art-in/meteos/README.md

Home weather station on [ESP32](https://en.wikipedia.org/wiki/ESP32) with database and web app.

---

- environment readings:
  - temperature
  - humidity
  - pressure
  - co2
 - sending readings to database over wifi
 - configuring sensor over bluetooth
 - on-board display to show current readings
 - browser web app to show history charts
 - notifications through Telegram bot

---

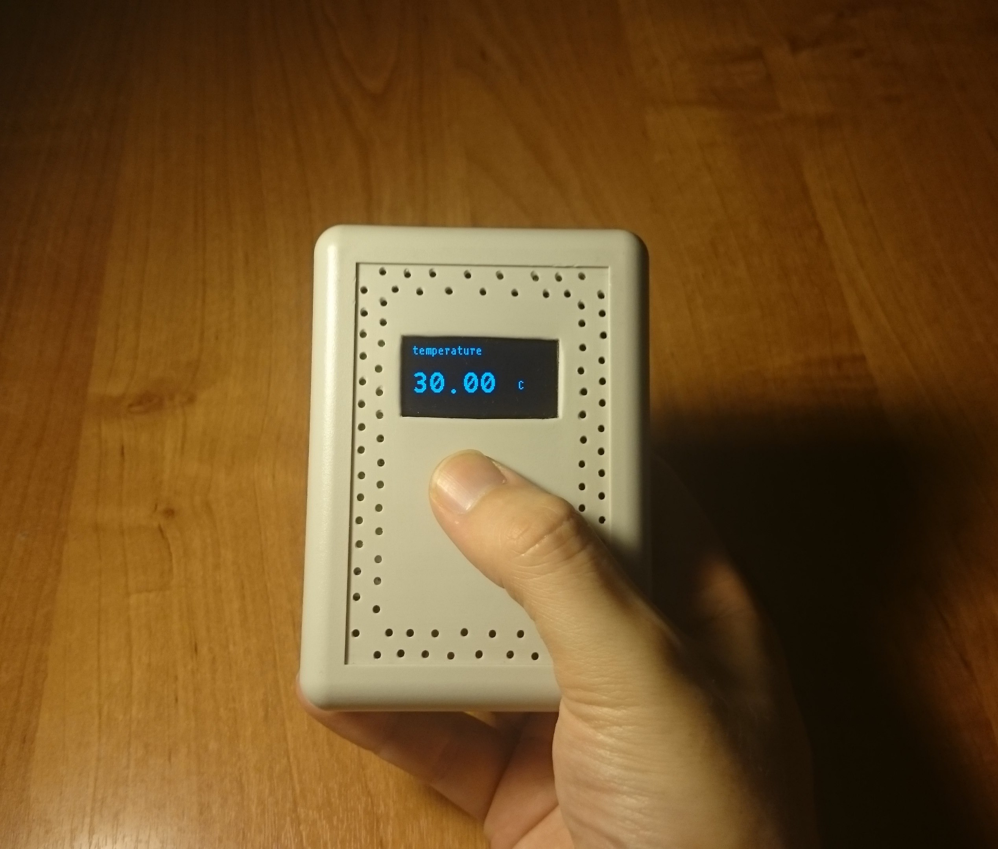
[picture p1: docs/sensor/photos/in-hand.jpg]
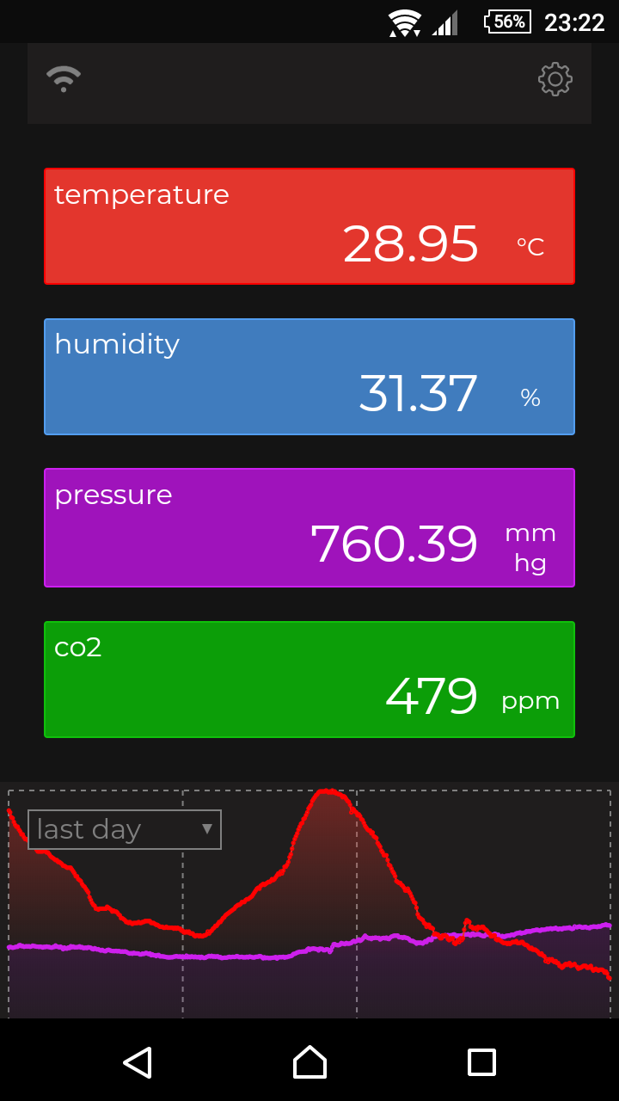
[picture p2: docs/web-app/phone.png]
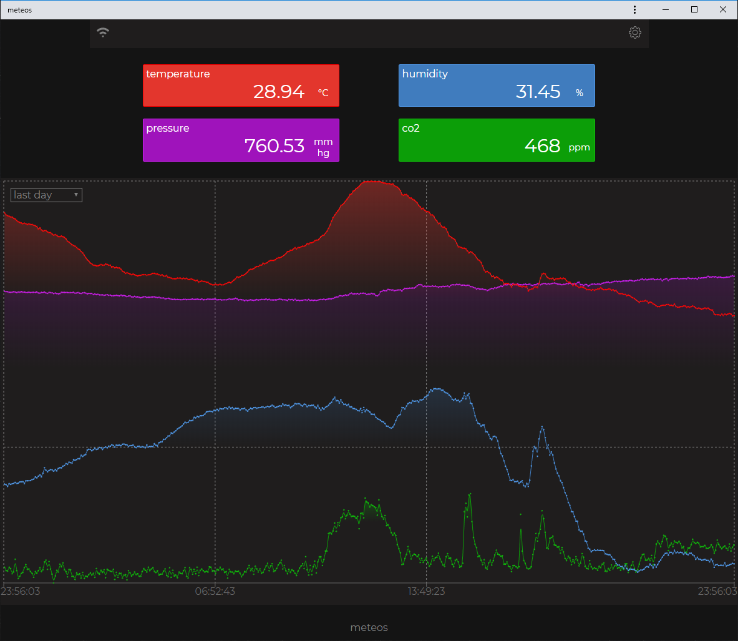
[picture p3: docs/web-app/desktop.png]
 |  | 
:---: | :---: | :---:

---

<a href="docs/architecture/meteos-architecture.pdf">
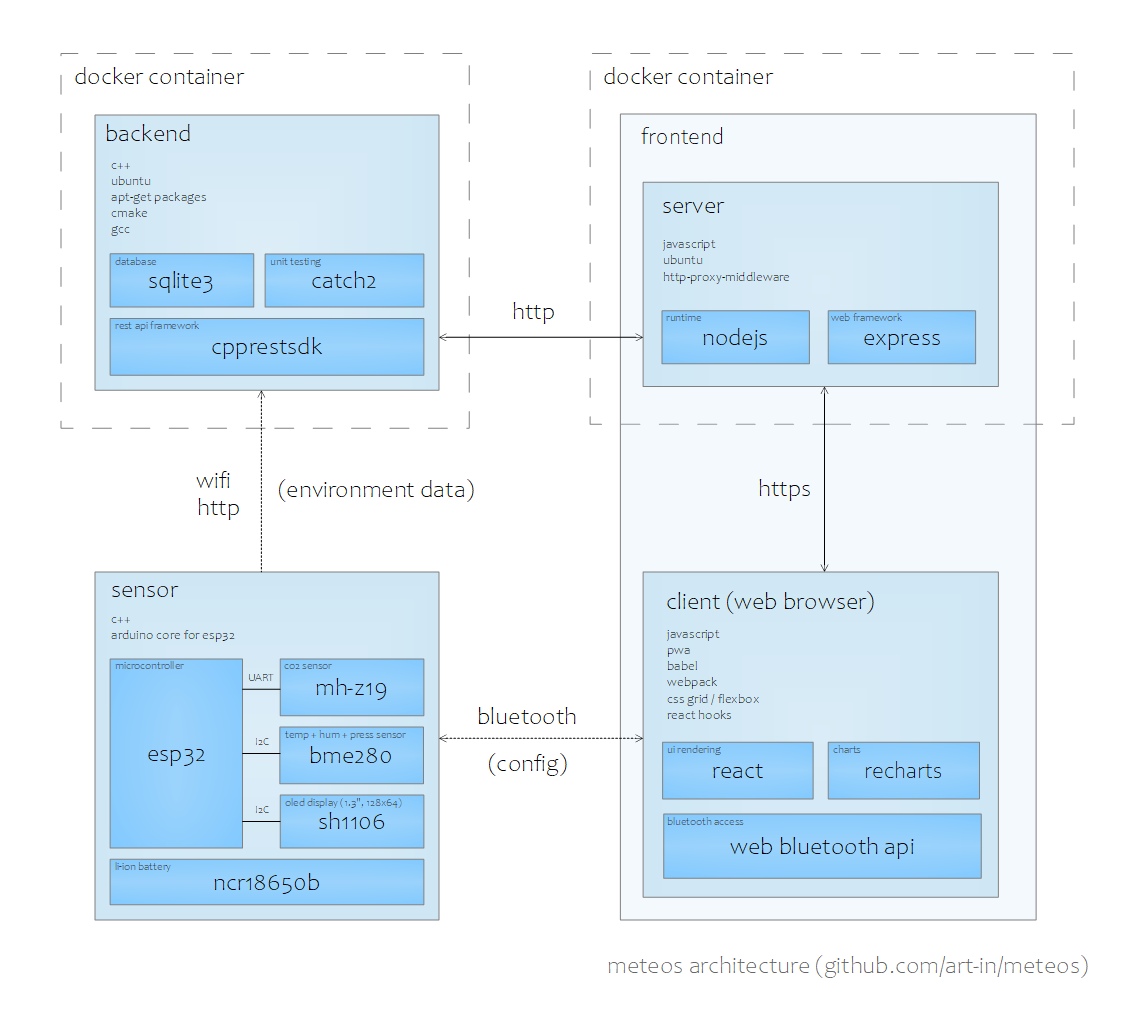
[picture p4: docs/architecture/meteos-architecture.png]

</a>

---

[Sensor device (components, circuit diagram, etc.)](docs/sensor/readme.md)

[Standards for indoor environmental quality](docs/environment-standards.md)
