art-in/meteos/docs/sensor/readme.md

### Components

component | model | link | photo 
--- | --- | --- | ---
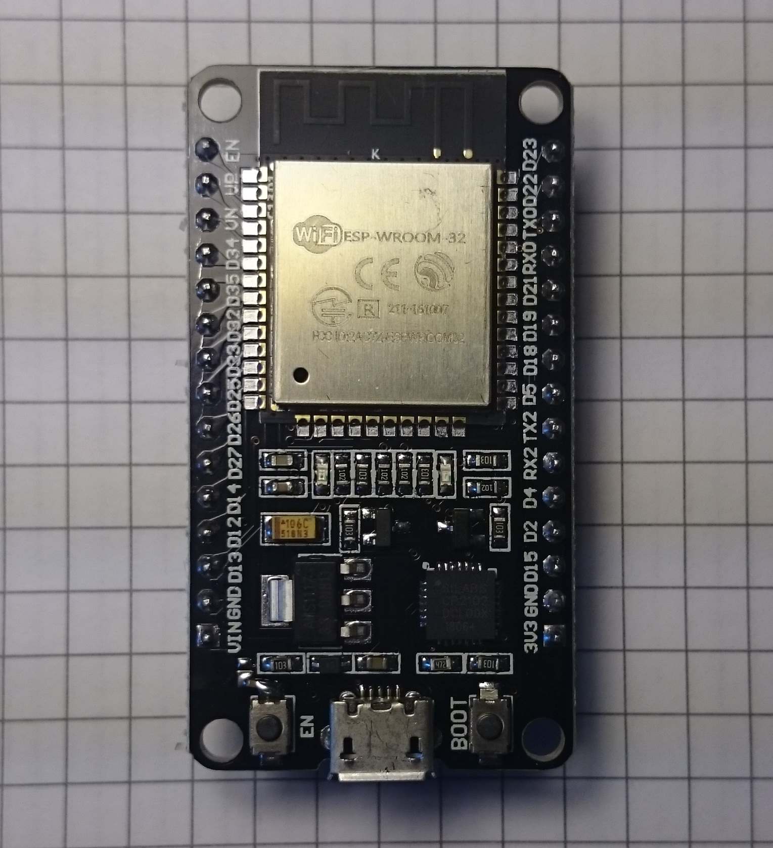
[picture p5: docs/sensor/photos/parts/esp32-dev-board.jpg]
microcontroller | esp32 doit devkit v1 | [aliexpress](http://aliexpress.com/item/ESP32-ESP-32-ESP32S-ESP-32S-CP2102-Wireless-WiFi-Bluetooth-Development-Board-Micro-USB-Dual-Core/32867696371.html) | 
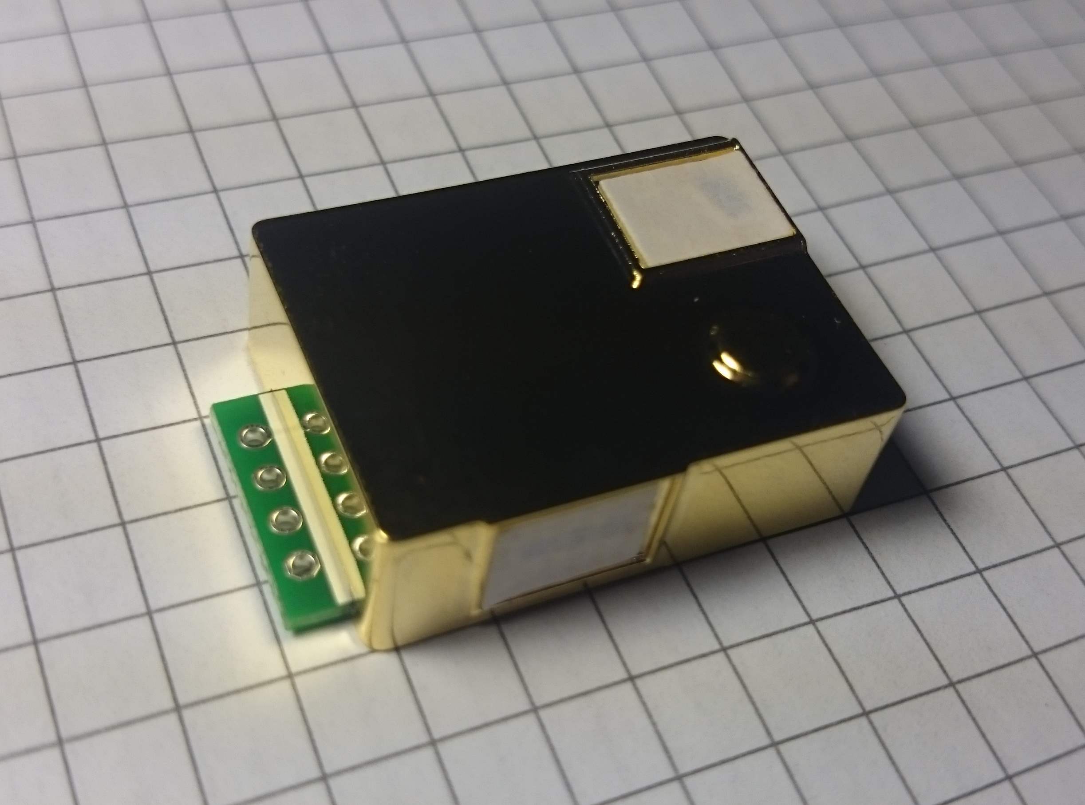
[picture p6: docs/sensor/photos/parts/mh-z19.jpg]
co2 sensor | mh-z19b | [aliexpress](http://aliexpress.com/item/1PCS-module-MH-Z19-infrared-co2-sensor-for-co2-monitor-Free-shipping/32371956420.html) | 
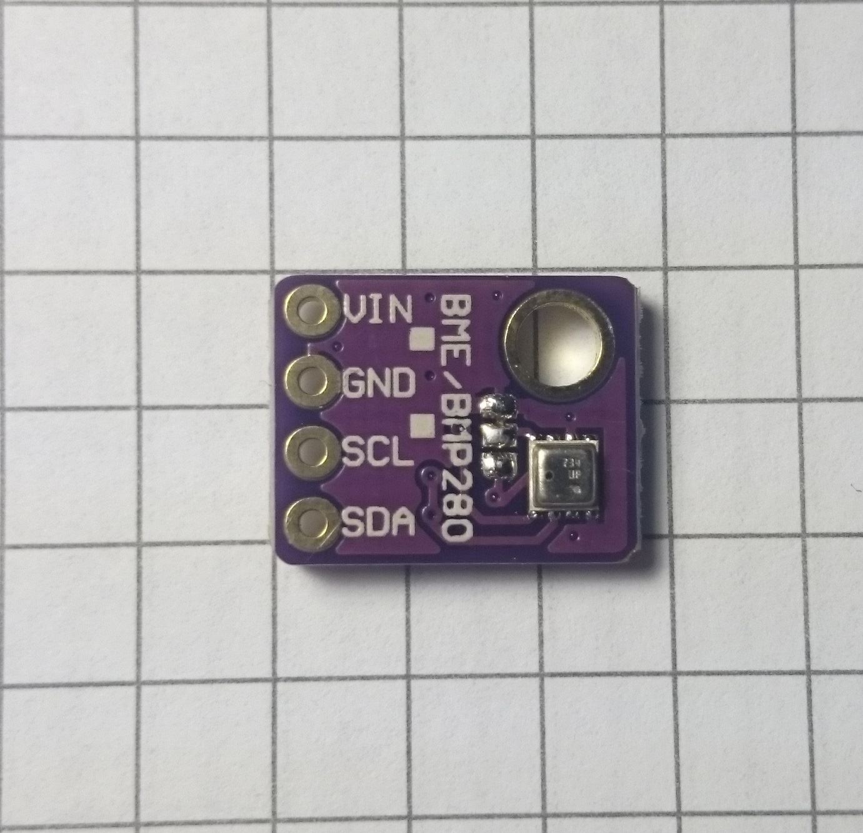
[picture p7: docs/sensor/photos/parts/bme280.jpg]
temperature, humidity, pressure sensor | bme280 | [aliexpress](http://aliexpress.com/store/product/BME280/731260_32849462236.html) | 
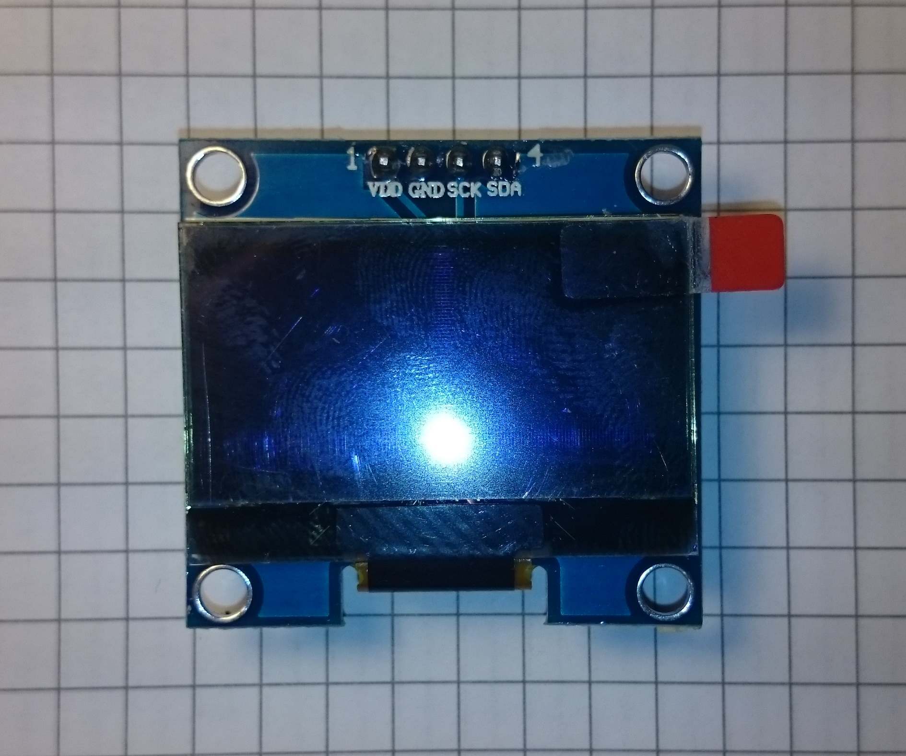
[picture p8: docs/sensor/photos/parts/sh1106.jpg]
OLED display (1.3", 128 x 64) | sh1106 | [aliexpress](http://aliexpress.com/item/1PCS-1-3-OLED-module-white-color-128X64-1-3-inch-OLED-LCD-LED-Display-Module/32796086867.html) | 
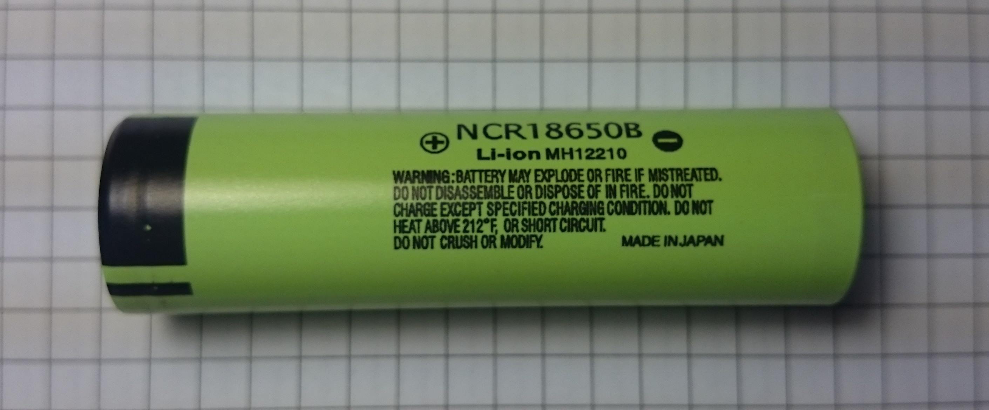
[picture p9: docs/sensor/photos/parts/ncr18650b.jpg]
li-ion battery (18650) | ncr18650b | [aliexpress](http://aliexpress.com/item/2PCS-100-New-Original-NCR18650B-3-7-v-3400-mah-18650-Lithium-Rechargeable-Battery-Flashlight-Digital/32324914059.html) | 
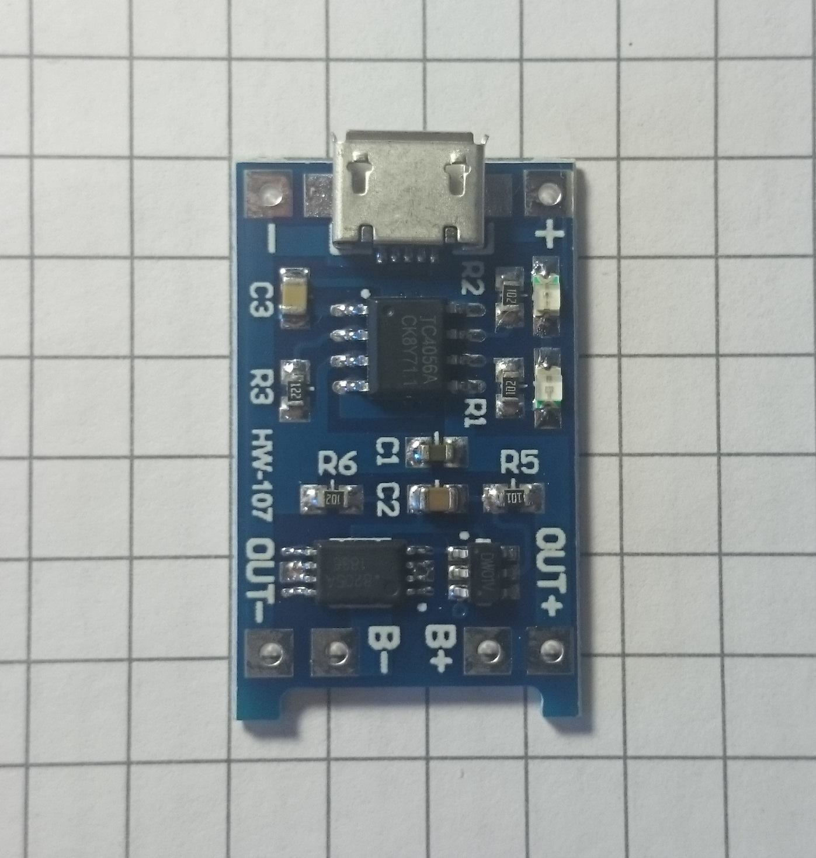
[picture p10: docs/sensor/photos/parts/tp4056.jpg]
li-ion battery charging board with protection | tp4056 | [aliexpress](http://aliexpress.com/item/1PCS-5V-1A-Micro-USB-18650-Lithium-Battery-Charging-Board-Charger-Module-Protection-Dual-Functions/32467578996.html) | 
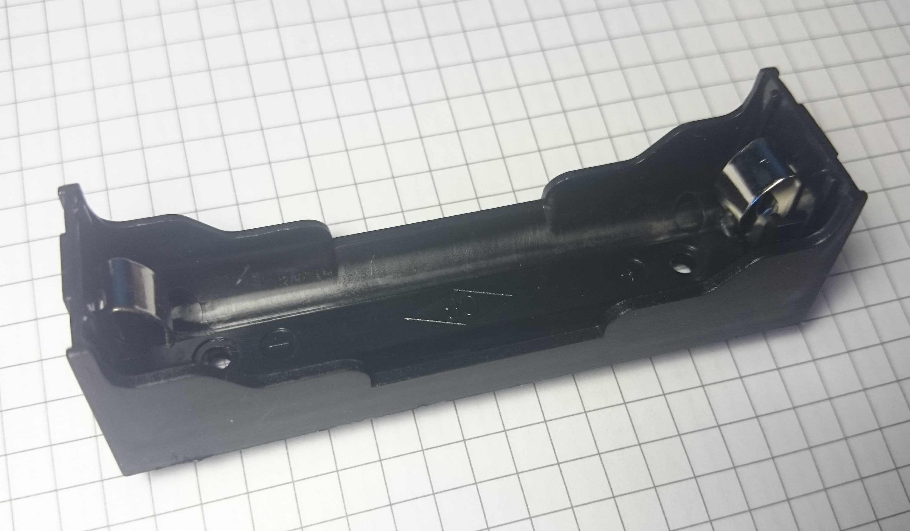
[picture p11: docs/sensor/photos/parts/battery-case.jpg]
battery case (18650) | - | [aliexpress](http://aliexpress.com/item/High-Quality-18650-Battery-Box-Holder-Batteries-Case-for-4pcs-18650-in-Parallel-3-7V-Pole/32814062027.html) | 
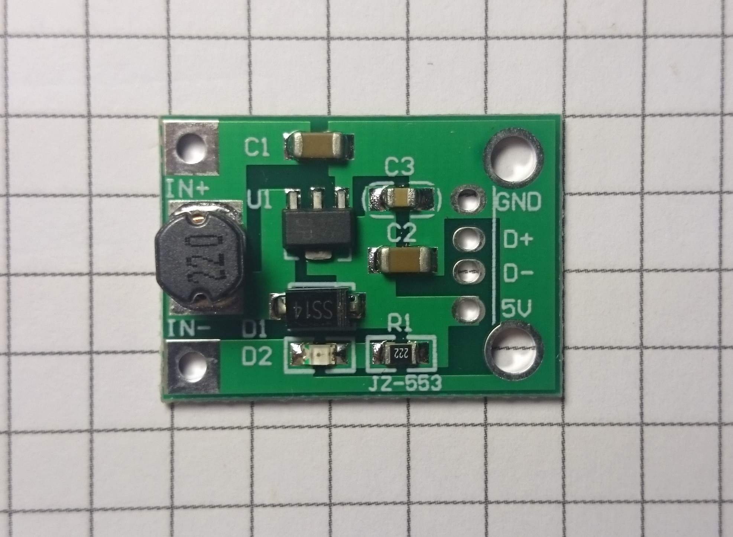
[picture p12: docs/sensor/photos/parts/stepup-converter.jpg]
step-up voltage converter (1V-5V to 5V) | - | [aliexpress](http://aliexpress.com/item/5V-DC-DC-Converter-Step-Up-Power-Supply-DC-DC-Booster-Boost-Buck-Converter-Board-Step/32635991770.html) | 
capacitor (1K μF) | - | -
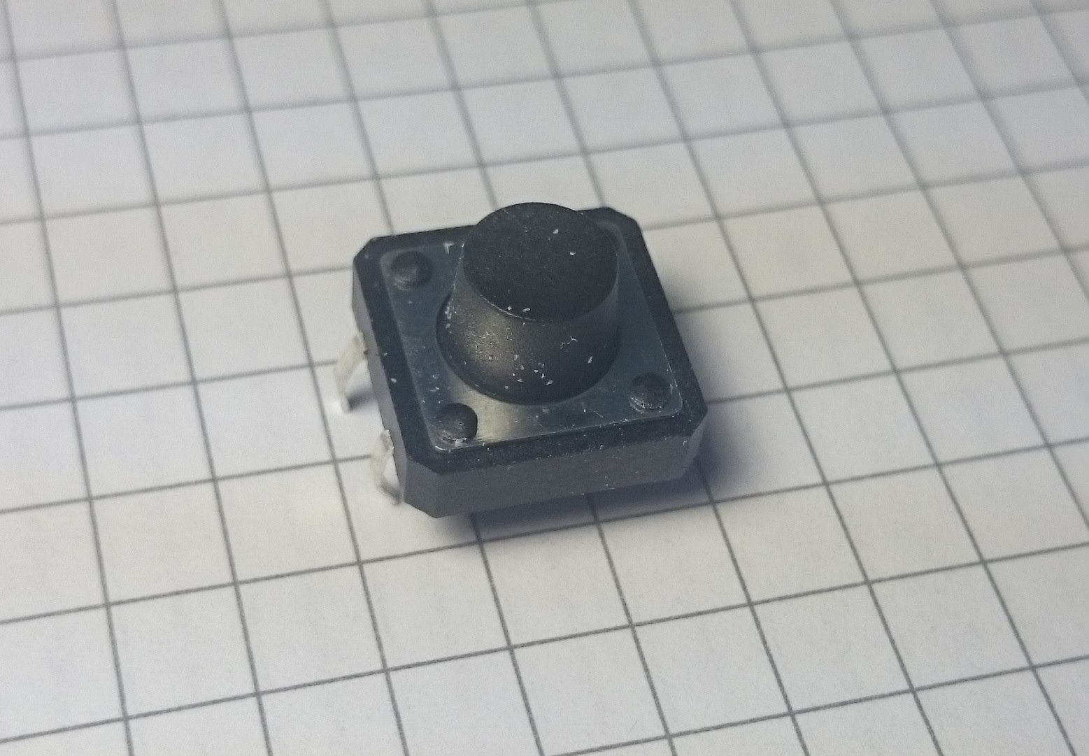
[picture p13: docs/sensor/photos/parts/button.jpg]
button | - | - | 
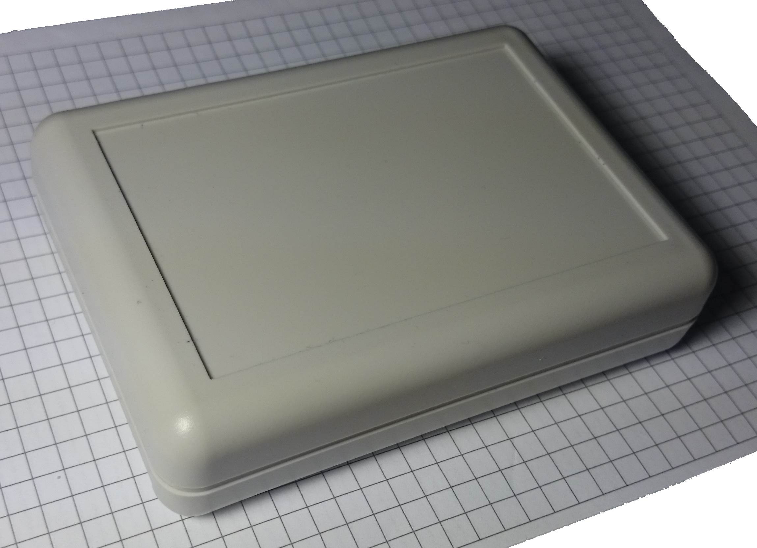
[picture p14: docs/sensor/photos/parts/case1.jpg]
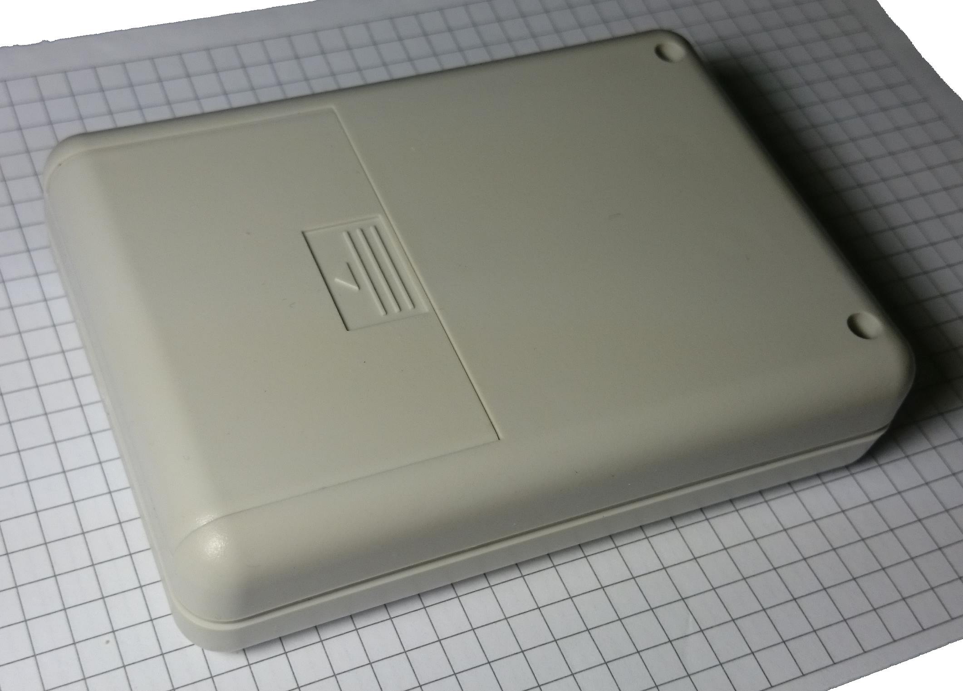
[picture p15: docs/sensor/photos/parts/case2.jpg]
plastic case (105 х 75 х 26.4 mm) | - | [chipdip (RU)](https://www.chipdip.ru/product/g909g) |  <br/> 

total cost (including shipment from China to Saint-Petersburg, Russia): 2.700 RUB (42 USD)  

most expensive component: co2 sensor - 1.230 RUB (19 USD)  
shipment time: 2-4 weeks

---

### Assembling

<span style="display: none"><span>  |  <span style="display: none"><span>
-- | --
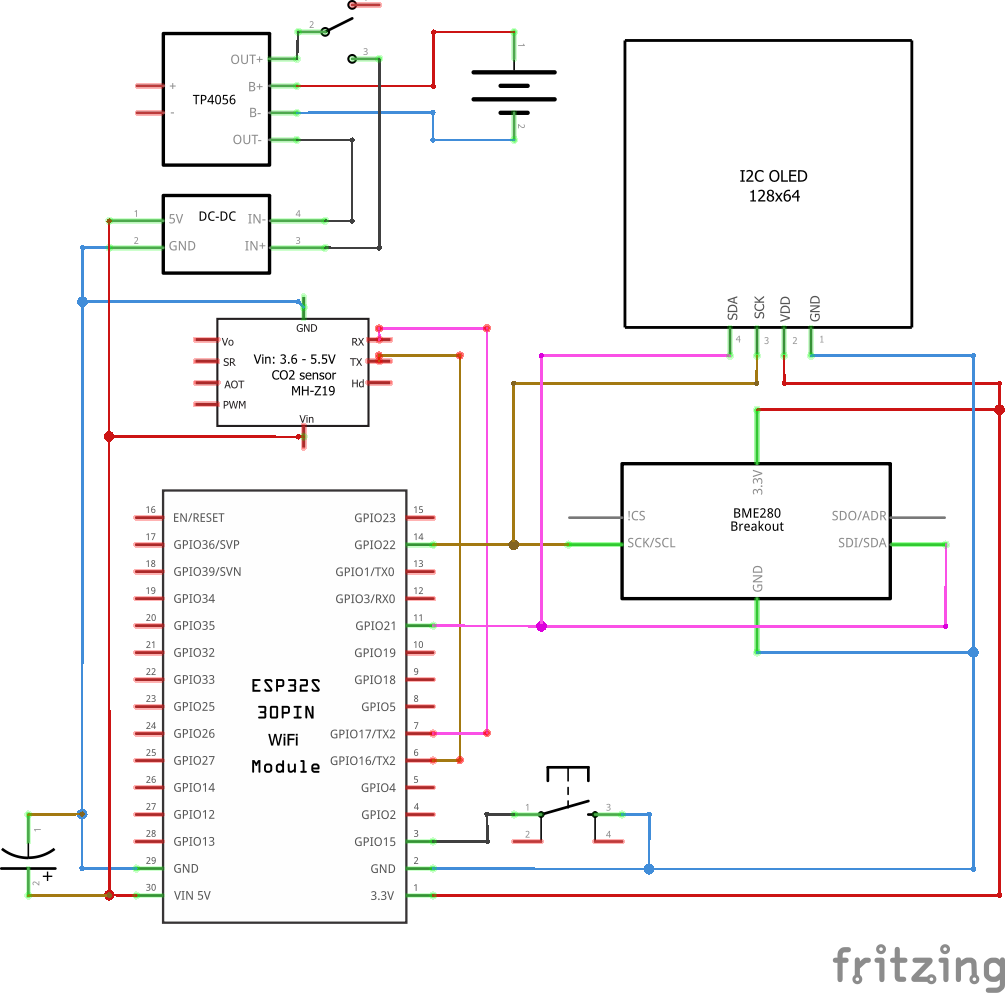
[picture p16: docs/sensor/circuit/meteos-sensor-circuit.png]
circuit diagram | 
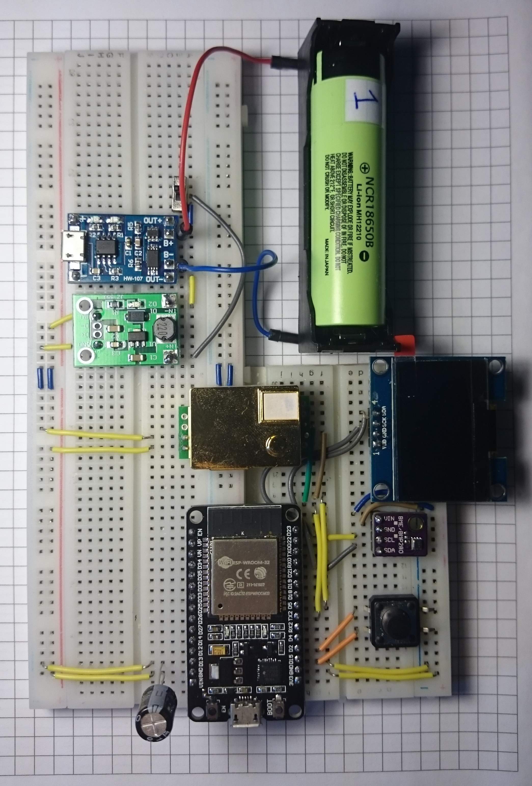
[picture p17: docs/sensor/photos/on-breadboard.jpg]
assembling on breadboard | 
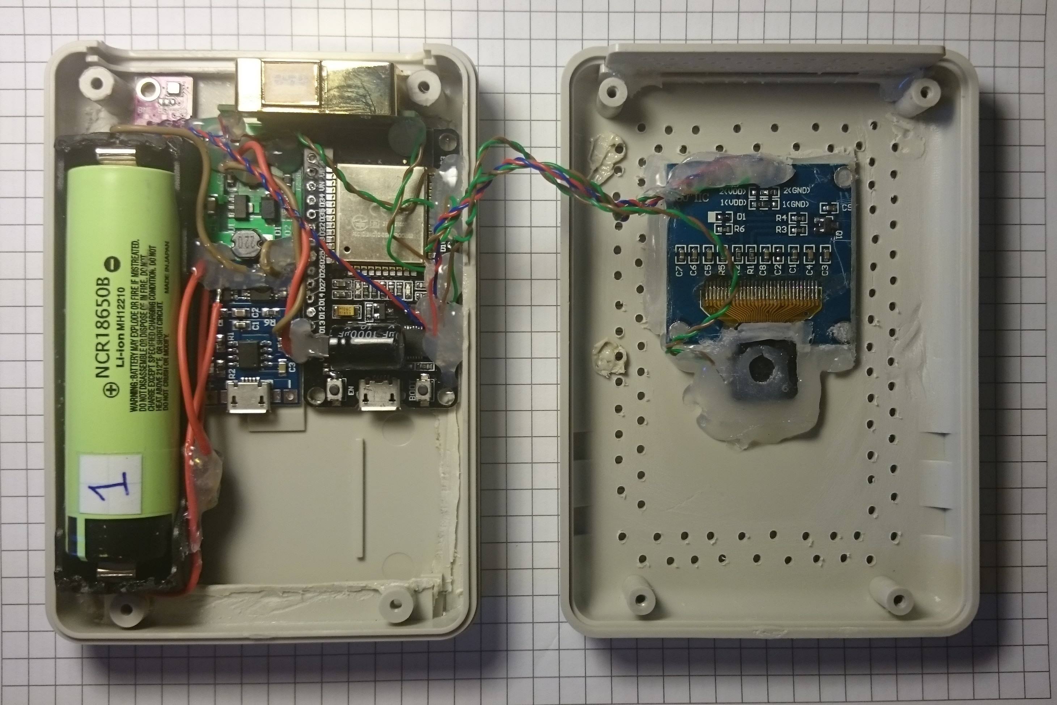
[picture p18: docs/sensor/photos/case-internals.jpg]
soldering / glueing / drilling / packing in case | 
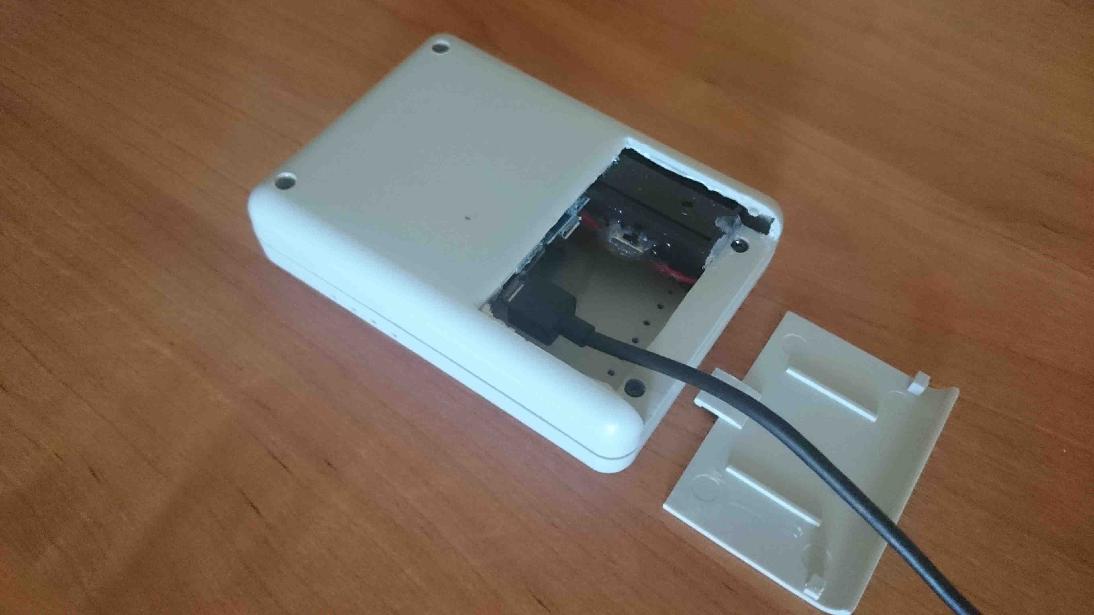
[picture p19: docs/sensor/photos/connecting-usb.jpg]
connecting to usb for charging / debugging | 
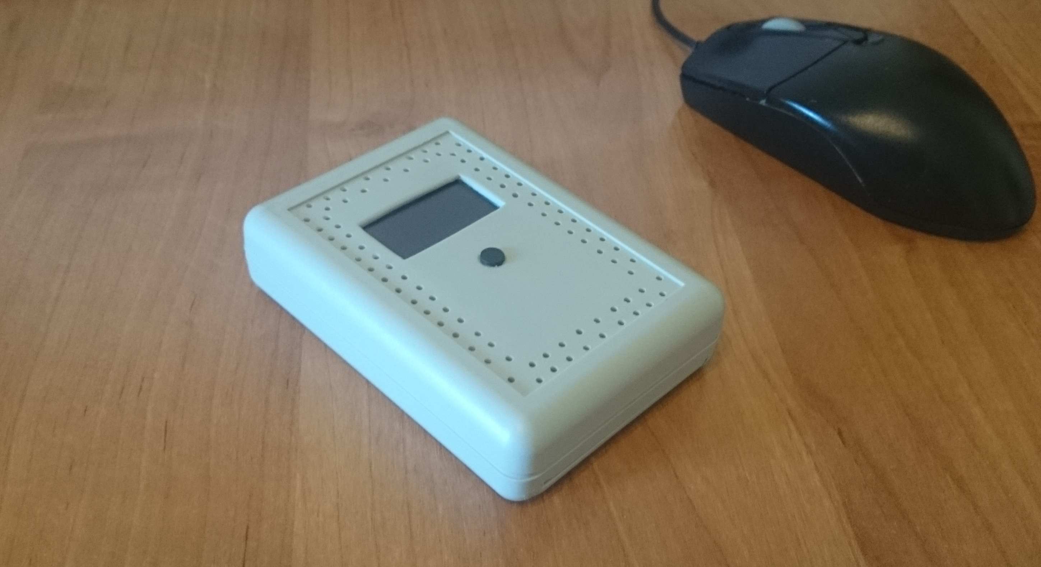
[picture p20: docs/sensor/photos/on-table.jpg]
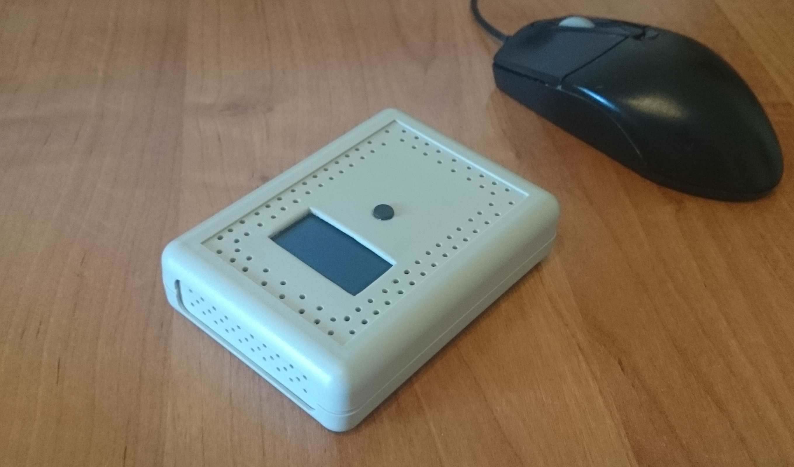
[picture p21: docs/sensor/photos/on-table-reverse.jpg]
front side |  <br> 

---

### Technical Parameters

<span style="display: none"><span>  |  <span style="display: none"><span>
-- | --
operating temperature range | 0 ~ 50 °C
weight | 136 g
average current | ~ 90 mA
on-battery life time | ~ 37 hours

---

### Design Failures

- short on-battery life time (despite all improvements [#34](https://github.com/art-in/meteos/issues/34)).  
    originally i've expected device to work at least 1 week on single battery charge. but it all comes down to this:
    - esp32 drains considerable amount of current for wifi operations (even in modem sleep mode).
    - mh-z19 was not designed for low-power consumption as it drains min 5 mA constantly with 100 mA peaks.
    
- temperature reading is affected by case self heating.  
    esp32 radiates most of the heat, and some more comes from mh-z19 and battery.  
    despite i've drilled a lot of holes on front panel and a side, looks like it's still not enough.  
    overall mistake is ~ +2 °C (gradually heating up for 1-2 hours after startup), which needs [firmware compensation](https://github.com/art-in/meteos/commit/2b7095b54528057cdad4de52b92796aa3bcfb0cc).
