art-in/meteos/docs/sensor/circuit/readme.md

Using [Fritzing](http://fritzing.org) for drawing circuit diagram.
