art-in/meteos/docs/architecture/meteos-architecture.pdf

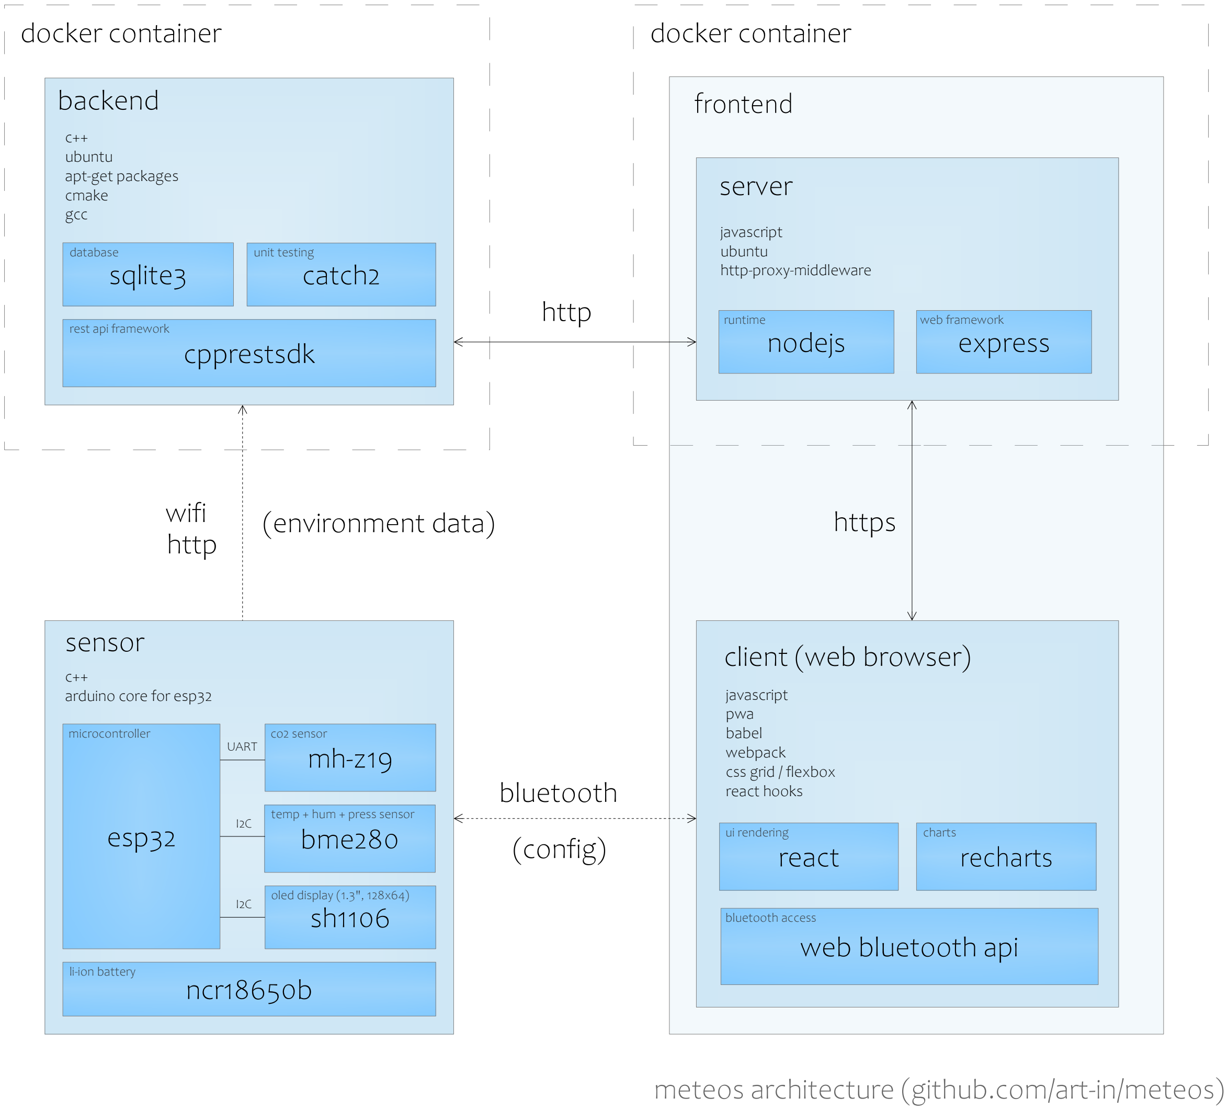
[picture p22: page 1]

sensor

esp32

mh-z19 UART

microcontroller | co2 sensor

bme280

temp + hum + press sensor

ncr18650b

li-ion battery

I2C

c++
arduino core for esp32

sh1106

oled display (1.3", 128x64) I2C

backend

sqlite3

cpprestsdk

catch2

c++
ubuntu
apt-get packages
cmake
gcc

database

rest api framework

unit testing

docker container

wifi
http

frontend

server

nodejs | express
runtime | web framework

react

ui rendering
recharts

charts

javascript
pwa
babel
webpack
css grid / flexbox
react hooks

javascript
ubuntu
http-proxy-middleware

web bluetooth api

bluetooth access

client (web browser)

docker container

http

https

bluetooth
(config)

(environment data)

meteos architecture (github.com/art-in/meteos)
