art-in/meteos/backend/readme.md

Meteos Backend.

Rest api service for storing environment data received from Sensor and serving it to Frontend.

---

Build & run in docker
---

Prerequisites: (1) [docker](https://www.docker.com/), (2) git, (3) unix shell (e.g. bash).

```
git clone https://github.com/art-in/meteos
cd ./meteos/backend

./docker/scripts/build.sh    # build inside container
                             # --clean - skip cache
                             # --test  - build tests

./docker/scripts/run.sh      # run inside container
                             # --test  - run tests

./docker/scripts/start.sh    # build & run
./docker/scripts/test.sh     # build & run tests
```

Notes:  
On linux, if docker requires `sudo` - setup it to run without `sudo` ([instructions](https://askubuntu.com/a/477554/950607)).

---

Run prebuild docker image
---

Prerequisites: (1) [docker](https://www.docker.com/).

```
# download image from docker hub and run it (set params first)
docker run -di \
    --restart unless-stopped \
    -p <port>:3000 \
    --mount type=bind,src=<database folder path>,dst=/opt/project/build/bin/data/ \
    artinphares/meteos-backend
```

Notes:  
Database folder path should (1) exist, (2) be absolute, (3) windows format: "/d/my/folder/".
