art-in/meteos/docs/environment-standards.md

### Optimal parameters of indoor environment

<span style="display:none"></span> | CIS | EU
-- | -- | --
temperature | 20-25 °C | 20-26 °C
humidity | 30-60 % | 25-60 %
co2 | < 1000 ppm | < 900 ppm

---

### Standards

- (CIS) [ГОСТ 30494-2011 "Параметры микроклимата в помещениях"](https://ugraces.ru/wp-content/uploads/2015/12/%D0%93%D0%9E%D0%A1%D0%A2-30494-2011-%D0%9F%D0%B0%D1%80%D0%B0%D0%BC%D0%B5%D1%82%D1%80%D1%8B-%D0%BC%D0%B8%D0%BA%D1%80%D0%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)
- (EU) [CEN 15251:2006 "Indoor environmental input parameters for design and
assessment of energy performance of buildings addressing indoor air quality, thermal environment,
lighting and acoustics"](http://www.cres.gr/greenbuilding/PDF/prend/set4/WI_31_Pre-FV_version_prEN_15251_Indoor_Environment.pdf)
