art-in/meteos/(threads)

Thread 52 (2019-05-24):

sensor firmware

art-in, 2019-05-24:
- [x] fix co2 zeroes on the start
- [x] fix wifi reconnect when AP reappears
- [ ] fix 30-sec sample gaps when on battery
- [x] compensate in-case heat

Closed 2019-06-17.

Thread 55 (2019-08-19):

sensor tries to post sample with empty humidity

art-in, 2019-08-19:
Logs:

```
2019-07-21T07:03:40.177Z - INFO  - 192.168.1.200 - POST /samples - {"t":25.77,"h":44.70,"p":757.84,"c":696}
2019-07-21T07:04:00.185Z - INFO  - 192.168.1.200 - POST /samples - {"t":25.78,"h":44.71,"p":757.79,"c":696}
2019-07-21T07:04:20.189Z - INFO  - 192.168.1.200 - POST /samples - {"t":25.78,"h":44.74,"p":757.83,"c":693}
2019-07-21T07:04:40.184Z - ERROR - 192.168.1.200 - POST /samples - {"t":25.77,"h":nan,"p":757.84,"c":689} - * Line 1, Column 17 Syntax error: Malformed literal
2019-07-21T07:05:00.190Z - INFO  - 192.168.1.200 - POST /samples - {"t":25.78,"h":44.71,"p":757.81,"c":683}
2019-07-21T07:05:20.196Z - INFO  - 192.168.1.200 - POST /samples - {"t":25.77,"h":44.82,"p":757.80,"c":681}
2019-07-21T07:05:40.203Z - INFO  - 192.168.1.200 - POST /samples - {"t":25.78,"h":44.66,"p":757.83,"c":685}
```

Frequency: 8 times in last month.

Thread 56 (2019-08-19):

calibrate temperature readings for low °C

art-in, 2019-08-19:
temperature calibration required because of self-heating problem.
error is different in low and high °C environment.

high °C was tested in natural summer time environment.
low °C was simulated by placing ice near sensor.

test low °C in winter time (~20 °C) and calibrate sensor accordingly.

Closed 2020-02-09.

Thread 57 (2019-08-19):

optimize GET /samples limit

art-in, 2019-08-19:
currently in order to limit number of samples in api response,
1. backend first fetches all samples for specified period from database
2. and then extracts required number of samples by even destribution along the set.

try to avoid fetching unnecessary rows from dabase by using smart query.

art-in, 2019-08-20:
"Smart" query works but appears to be slower than current approach.
Probably because it passes rows thriсe: by two window functions (`NTILE` and `ROW_NUMBER`), and final pass to extract rows.

Also version of sqlite we use `3.22.0` does not support window functions, as they were added in `3.25.0`.

<details>
<summary>"Smart" query with window functions</summary>

```sql
SELECT DATETIME, TEMPERATURE, HUMIDITY, PRESSURE, CO2
FROM (
    -- numerate rows in each group
    SELECT *, ROW_NUMBER() OVER (PARTITION BY grp ORDER BY DATETIME) in_grp_num
    FROM (
      -- split set on 300 groups
      SELECT *, NTILE(300) OVER (ORDER BY DATETIME) grp
      FROM SAMPLES
	  WHERE DATETIME BETWEEN '2018-07-15T21:25:58.350Z' AND '2019-09-15T21:28:38.379Z'
    )
)
WHERE
    -- take first row from each group and last row from entire set
    in_grp_num = 1 OR
    DATETIME = (SELECT MAX(DATETIME) FROM SAMPLES WHERE DATETIME BETWEEN '2018-07-15T21:25:58.350Z' AND '2019-09-15T21:28:38.379Z')
```

</details>

art-in, 2019-08-20:
Samples table contains ~145.000 rows, its age ~ 1.5 month.

Before: extract all rows, map to Sample struct, filter by limit.

---

(all samples) `api/samples?limit=300`

Before: 1.400ms

---

(last month) `api/samples?limit=300&from=2019-07-20T08%3A43%3A44.021Z`

Before: 1.150ms

---

(last day) `api/samples?limit=300&from=2019-08-19T08%3A47%3A27.040Z`

Before: 50ms

Closed 2019-08-21.

Thread 58 (2019-09-09):

sensor dies after long uptime

art-in, 2019-09-09:
every ~1.5 month sensor stops posting samples to backend and reacting to button.
hard power reset needed to revive it. noticed two times.

backend log has nothing interesting, just cold stop with no errors.
should be bug in sensor firmware.

check for some 32-bit timer overflow first...

update: happened again after 11 days uptime.

art-in, 2022-05-19:
works OK for 3 years now. not noticing such behavior

Closed 2022-05-19.

Thread 59 (2019-11-20):

notify when environment readings go out of healthy range

art-in, 2019-11-20:
currently you have to check web-app or sensor preriodically to see if everything is still ok.
but sometimes you can can forget and sit in high co2 environment for several hours without noticing.

try to notify user when some environment readings go out of "normal" range.

- configuration
  - ranges should be configurable, and not hardcoded.
  - use [environment standards](https://github.com/art-in/meteos/blob/master/docs/environment-standards.md) for default ranges.
  - configuration should be consistent across sensor and all clients (web-app on different devices).
    TODO: need to figure out how to do that. options that won't work:
    - current web-app configuration form (not every device support BLE)
    - putting notification flag to each reading on sensor (ranges can be changed later)

- notification
  - notification should be unobtrusive (no sound, no blinking leds, no popups)
  - sensor: blinking icon on OLED display
  - web-app: bright icon in the header, range lines in the chart

art-in, 2022-05-19:
decided to create simple notification service through telegram bot as a start. can be replaced/extended by html5 push notifications for web-app in future.

ignore on-sensor and web-app notifications for now.

simplified spec:

- notification service should notify user when environment readings go out of "normal" range
- use [environment standards](https://github.com/art-in/meteos/blob/master/docs/environment-standards.md) as "normal" ranges
- subscription to notifications should happend through configuration section of web-app
