art-in/meteos/docs/sensor/circuit/meteos-sensor-circuit.pdf

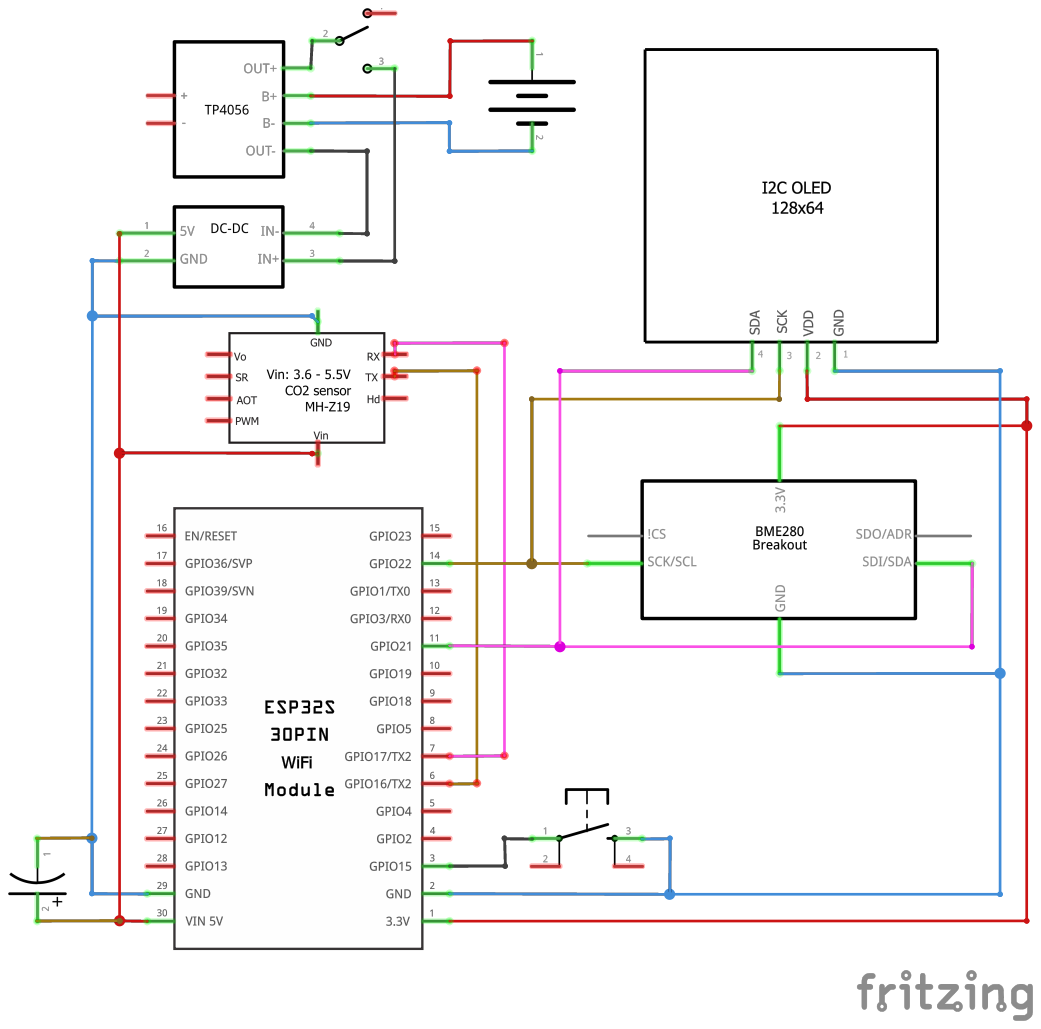
[picture p23: page 1]
