art-in/meteos/(list of files, drawings)

Other design files:
docs/sensor/circuit/meteos-sensor-circuit.fzz
