art-in/meteos/notifications/src/config.rs

use anyhow::Result;
use log::LevelFilter;
use std::{fs::File, io::Read, ops::Range, time::Duration};

#[derive(Debug, serde::Deserialize)]
pub struct Config {
    pub log_level: LevelFilter,
    pub backend_url: String,
    pub tg_bot_token: String,
    monitoring_interval_sec: u64,
    monitoring_period_sec: u64,
    backend_error_timeout_sec: u64,
    pub optimal_ranges: ReadingRanges,

    #[serde(skip)]
    pub monitoring_interval: Duration,

    #[serde(skip)]
    pub monitoring_period: Duration,

    #[serde(skip)]
    pub backend_error_timeout: Duration,
}

#[derive(Debug, serde::Deserialize, Clone)]
pub struct ReadingRanges {
    pub temperature: Range<f64>,
    pub humidity: Range<f64>,
    pub co2: Range<f64>,
    pub pressure: Range<f64>,
}

impl Config {
    pub fn read() -> Result<Self> {
        let mut str = String::new();
        File::open("./config.toml")?.read_to_string(&mut str)?;
        let mut config: Config = toml::from_str(&str)?;

        config.monitoring_interval = Duration::from_secs(config.monitoring_interval_sec);
        config.monitoring_period = Duration::from_secs(config.monitoring_period_sec);
        config.backend_error_timeout = Duration::from_secs(config.backend_error_timeout_sec);

        Ok(config)
    }
}
