art-in/meteos/(commit log)

2019-05-02 #44 tune test framework
2019-05-13 backend: fix posting json with big numbers
    sprintf with small target buffer led to overflow and crash
    [env-db.cpp]
2019-05-16 backend: limit samples in GET response
2019-05-24 #52 sensor: firmware draft
2019-05-24 #52 sensor: add lib sources
2019-05-24 #52 sensor: log to oled display
2019-05-25 #52 sensor: deep sleep
2019-05-26 frontend: fix samples loading after long time gap
    case: open app, hibernate os for time longer than period, open app.
    result: sample load period starts from last one loaded long time ago.
    fix: do not extend load period longer than current period.
2019-05-27 #52 sensor: refactor deep sleep code
2019-05-30 #52 sensor: replace deep sleep with modem sleep
    [button.cpp, button.h, config.cpp, config.h, display.cpp, display.h, main.ino, radio-bt.cpp]
2019-05-31 sensor: rename main.ino to sensor.ino
    to be able to build in Arduino IDE
2019-05-31 sensor: add readme.md
2019-05-31 sensor: update readme.md
2019-06-03 #52 sensors: fix co2 zeros after warmup
    [sensors.cpp]
2019-06-04 sensor: add links to third-party lib sources
2019-06-04 #52 sensor: reduce wifi reconnects per delay
2019-06-04 sensor: log with macros
2019-06-04 sensor: remove test bt client
2019-06-04 #8 sensor: add host/port, sample delay to config
2019-06-05 sensor: fix co2 display units
    [display.cpp]
2019-06-05 #53 frontend: add sensor configuration form
2019-06-06 #26 sensor: add "how it looks" section to readme
2019-06-06 #26 sensor: add parts and photos to readme
2019-06-07 #26 sensor: move assembling docs to separate dir
2019-06-07 #24 sensor: add circuit diagram
    [meteos-sensor-circuit.fzz]
2019-06-10 sensor: update docs
2019-06-11 #7 sensor: add tech params and design fails to doc
2019-06-17 #52 sensor: compensate case self heating
2019-06-18 #52 sensor: code cleanup
2019-06-19 frontend: tune default chart range on y-axis
2019-07-15 sensor: fix mhz warming period
    have used second units where it should be microseconds
    [sensors.cpp]
2019-07-15 sensor: fix sample delay saving in preferences
    looks like arduino preferences bug:
    value is not saved/extracted when key is too long.
    [config.cpp]
2019-07-17 frontend: limit samples on chart by viewport size
2019-08-19 sensor: calibrate temperature readings for high °C
2019-08-21 #57 backend: do not extract unnecessary rows
    before: extract all rows, map to Sample struct, filter by limit.
    after: iterate over cursor, only extract necessary rows by idx, map to Sample struct.
2020-02-09 #56 sensor: calibrate temperature readings for low °C
2020-02-09 sensor: code cleanup
